jawadbarbara/seat-position-sensors/Positions/positions.jpg

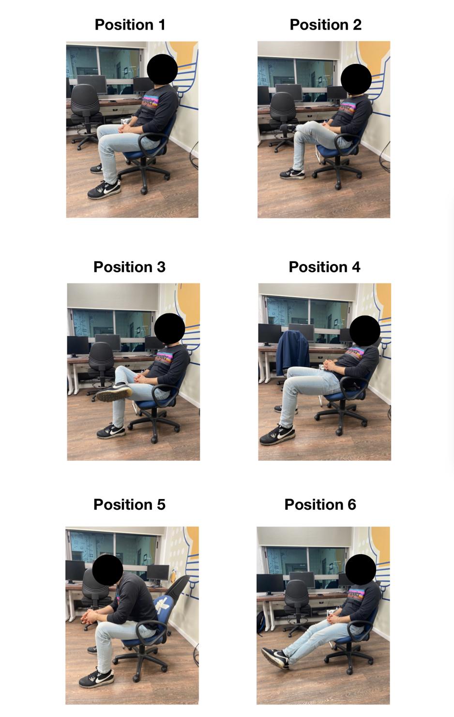
Positions/positions.jpg
