jawadbarbara/seat-position-sensors/Unit Tests/Button_Test/Button_Test.ino

const int buttonPin = 13;  // the number of the pushbutton pin

// variables will change:
int buttonState = 0;  // variable for reading the pushbutton status

void setup() {
  // initialize the pushbutton pin as an input:
  pinMode(buttonPin, INPUT);
}

void loop() {
  // read the state of the pushbutton value:
  buttonState = digitalRead(buttonPin);

  // check if the pushbutton is pressed. If it is, the buttonState is HIGH:
  if (buttonState == HIGH) {
    Serial.println("button pressed");
  } 
}
