jawadbarbara/seat-position-sensors/Unit Tests/Sensor_Test/Sensor_Test.ino

const int analogInPin = 27;  // Analog input pin that the potentiometer is attached to

int sensorValue = 0;  // value read from the pot

void setup() {
  // initialize serial communications at 9600 bps:
  Serial.begin(9600);
}

void loop() {
  // read the analog in value:
  sensorValue = analogRead(analogInPin);

  // print the results to the Serial Monitor:
  Serial.print("sensor = ");
  Serial.print(sensorValue);
  delay(2);
}
